an-erd/spBox/Box/spBox_Photo2.JPG

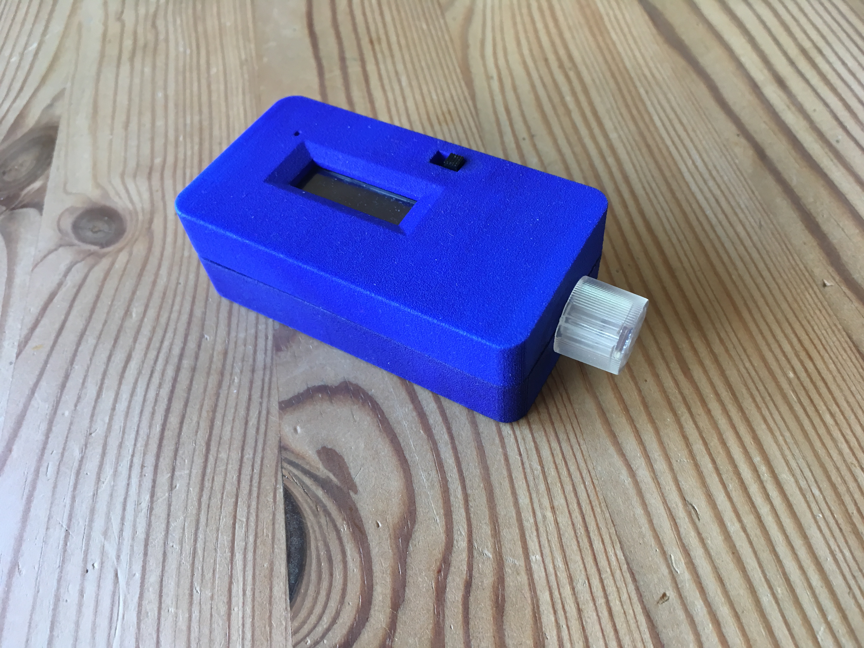
Box/spBox_Photo2.JPG
