an-erd/spBox/Box/spBox_Photo1.JPG

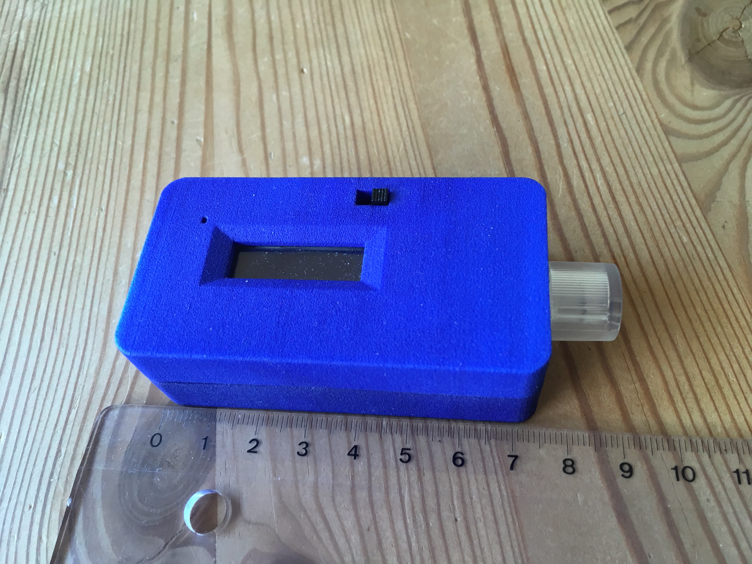
Box/spBox_Photo1.JPG
