an-erd/spBox/Box/spBox_1.png

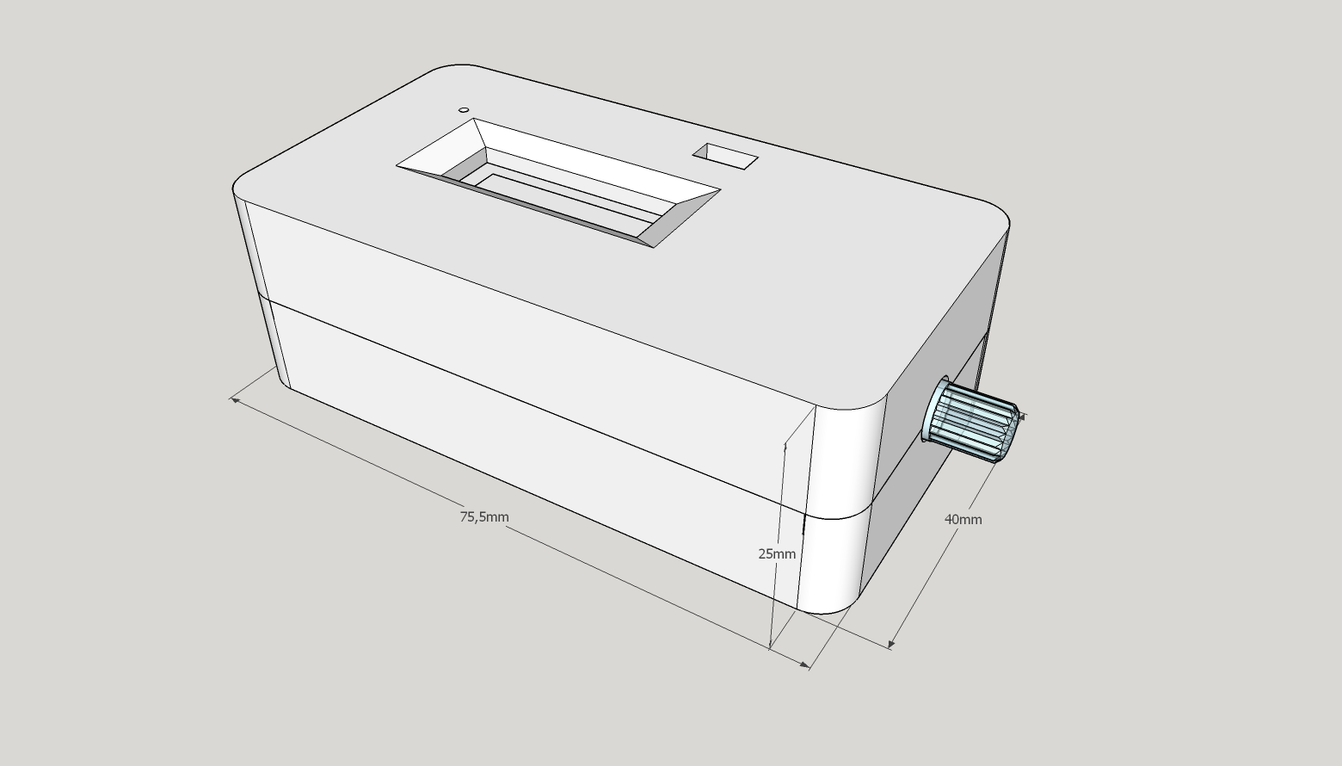
Box/spBox_1.png
