an-erd/spBox/Box/spBox_2.png

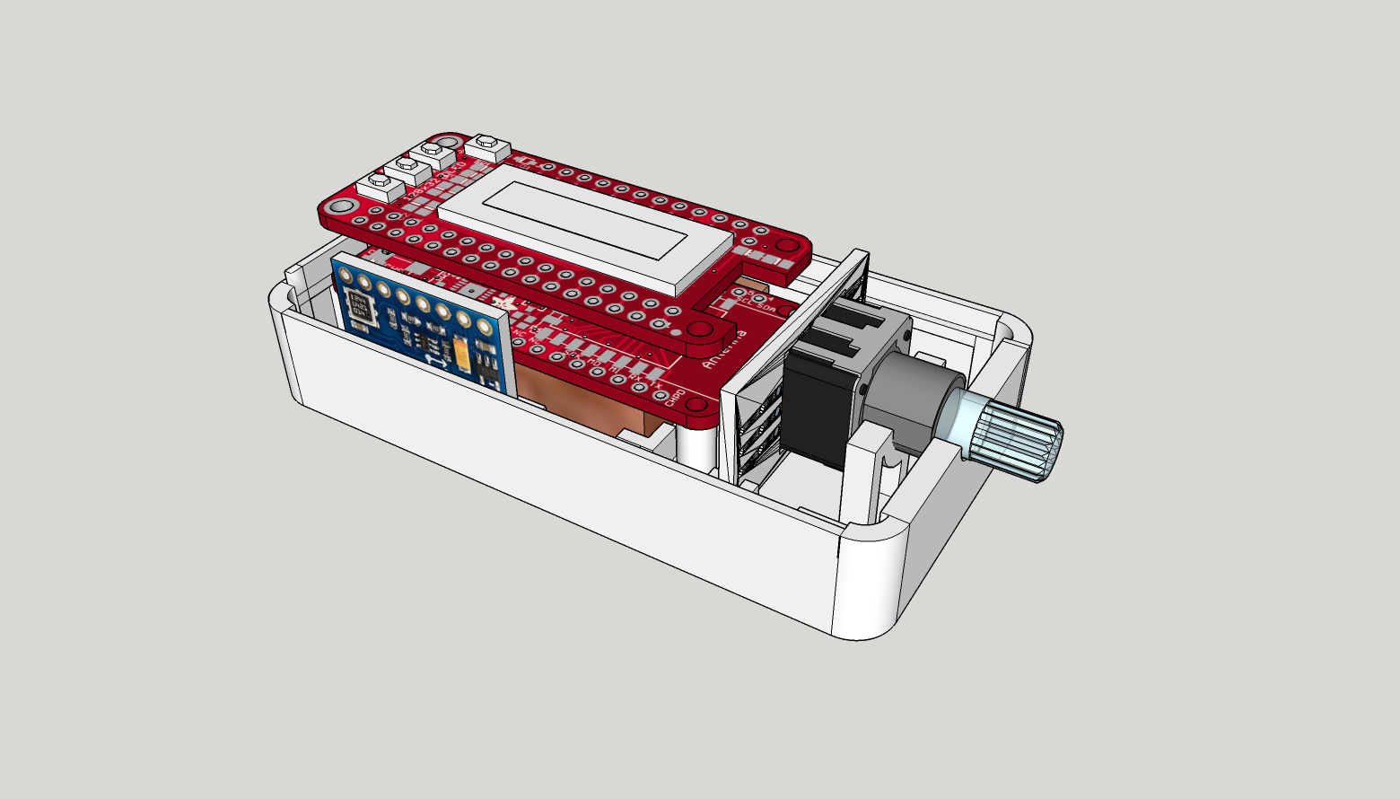
Box/spBox_2.png
