an-erd/spBox/(threads)

Thread 11 (2017-05-10):

functional class method callback

an-erd, 2017-05-10:
get class method callback for ISR working
i.e. fetch commit from 2.4.x ESP core tree, get rid of wrapper function,
see https://github.com/esp8266/Arduino/pull/2745

an-erd, 2017-06-26:
getting stack traces and exception (0) when using this pull request

Thread 17 (2017-05-10):

check/adjust file name and solution/project update

an-erd, 2017-05-10:

an-erd, 2017-05-31:
seems to be OK with using Arduino 1.6/1.8 and not Visual Micro.
Open: check environment variable as a shortcut to get rid of an additional "../"

Closed 2017-06-10.

Thread 20 (2017-05-10):

power saving

an-erd, 2017-05-10:
power saving, in particular sleep modes w/PIN16, shut down and restart, at least minimize GY-87 power consumption, desolder voltage regulator, LED

an-erd, 2017-06-19:
Switch to modem sleep mode, see http://www.espressif.com/sites/default/files/9b-esp8266-low_power_solutions_en_0.pdf

Thread 32 (2017-05-10):

calibrate vbat

an-erd, 2017-05-10:

an-erd, 2017-05-31:
open box and measure voltage, then adjust LSB and max in calculation

an-erd, 2017-06-10:
values seem pretty good, no adjustment necessary

an-erd, 2017-06-11:
Ok, after a couple of charging cycles the calibration needs to be done, new values in code and documented in the readme.

Closed 2017-06-11.

Thread 61 (2017-05-30):

Max. Accel reset w/timer

an-erd, 2017-05-30:
wait 3 seconds, that we don't measure butten release

Closed 2017-05-30.

Thread 62 (2017-05-30):

Accel/Gyro max reset w/timer

an-erd, 2017-05-30:

Closed 2017-05-30.

Thread 71 (2017-06-03):

Show Reset timer with "progress bar"

an-erd, 2017-06-03:

Closed 2017-06-03.

Thread 85 (2017-07-08):

Rotary encoder and button events are ignored

an-erd, 2017-07-08:
It seems, that by LCDMenuLib some events (up, down, ...) are not completed. The root cause seems to be that with LCDML_BUTTON_enter() and similar functions, two actions are started - one for this event (with a timer = millis()+1) and than the menu update itself:
`#	define LCDML_BUTTON_enter()	LCDML.Button_enter();					LCDML_DISP_update_menu()
#	define LCDML_DISP_update_menu()\
	g_lcdml_initscreen = millis();\
	if (LCDML.getFunction() != _LCDML_NO_FUNC){\
		LCDML_BACK_start(LCDML_BACKEND_menu);\
	} \
	if (!bitRead(LCDML.button,  _LCDML_button_quit)) {\
		bitClear(LCDML.button,  _LCDML_button_quit);\
		LCDML_lcd_menu_display(); \
	}
`
When not in the menu but in a function, you can see with debug statements that LCDML_lcd_menu_display() has been executed, but not the "loop()" function.

Todo:

check inside macros, in particular
`#	define LCDML_DISP_update_end() \
		bitClear(LCDML.control, _LCDML_control_disp_update); \
		bitClear(LCDML.control, _LCDML_control_cursor_update); \
		bitClear(LCDML.control, _LCDML_control_update_direct)`
