an-erd/spBox/(commit log)

2016-10-31 simple i2c scanner added
    for mpu-6050 i2c pass-through enabled
2016-10-31 initial check in of 10DOF code for GY-87 based on I2Cdevlib
2016-11-12 add MPU6050_raw to calibrate accel/gyro
2017-02-19 rotary encoder code added
2017-02-19 temp rotary encoder test
2017-02-24 work: timer
2017-02-25 wip, not working yet
    [spBox.ino]
2017-03-05 first working complete prototype, without any exceptions etc.
2017-03-06 included WLAN code and button logic, works w/o problems
    [spBox.ino]
2017-03-08 changed gyro from deg/s to rad/s, commens on power consumtion, cleanup
2017-04-11 WIP, not working (new OLED class added)
    [spBox.ino]
2017-04-13 WIP, back button and LCDML working, basic navigation structure donw
2017-04-20 Battery monitoring (HW and SW) added
2017-04-20 MQTT upload works, now cleanup and use of timer necessary
2017-04-27 button and rotenc example (i.e. test sketch) added
2017-04-28 WIP example sensor_display
2017-04-28 WIP sensor_display_example, got rid of BMP085_NG again, finally
2017-05-01 dir restructuring completed, with new Arduino IDE version/Visual Micro
2017-05-01 dir restructuring and new arduino ide version
2017-05-01 example button_rotenc working
2017-05-02 complete build w/o errors
    [myconfig.h]
2017-05-03 add board.txt
2017-05-03 WIP, display not working with LCDML
    [spBox.ino]
2017-05-04 pretty good running version, with lcd menu delay solved
    [LCDML_DEFS.h, LCDML_DISP.ino, LCDML_FUNC_DISP.ino, myconfig.h]
2017-05-06 compass functionality completed and tested. Magnometer calibration added and adjusted for Germany, Stuttgart. Compass, heading, direction is displayed correctly, menu display function added.
    [LCDML_DEFS.h, LCDML_DISP.ino, LCDML_FUNC_DISP.ino, myconfig.h, sensor_display.ino, spbox_sensors.cpp]
2017-05-07 added WLAN/Battery function again, battery needs calibration process, gesides that tested ok
2017-05-07 improved vBat calibration, factor vor divider
2017-05-13 added async ping, updated COM with ping per timer, updated display to indicate Inet, cleanup. Conmpiles fine, first test ok
2017-05-13 Issue #36 resolved, Display information on NTP time screen, and in WLAN status on internet connectivity.
    [spbox_com.cpp]
2017-05-13 Add MIT license file header to all files, first part of Issue #5
    [button.cpp, button.h, button_rotenc.ino, com_conf.ino, missing_str_util.cpp, myconfig.h, rotenc.cpp]
2017-05-14 Issue #12: MQTT implemented, AsyncMQTT library instead of Adafruit MQTT, compiles and works good, but Inet and MQTT restart, ping timer, MQTT timer needs to be reworked
    [myconfig.h, spBox.ino, spbox_com.cpp, spbox_com.h]
2017-05-15 WIP, initscreen, display off implemented and roughly tested, compoiles and works. Detailed tests necessary
    [battery_2017-05-15_0502.csv]
2017-05-16 deleted and ignored *.vcxproj.filters files add additional battery data (csv)
2017-05-16 battery csv
    [battery_2017-05-15_0502.csv]
2017-05-16 csv file CRLF
    [battery_2017-05-16_0947.csv]
2017-05-20 added battery w/USB power
    [battery_2017-05-16_0438.csv]
2017-05-20 added BOM.txt with Bill of Material
